kanaya/Pineapple_II/doc/hardware.md

# Pineapple II

_Edition 2.0.5 for Pineapple II version 2.0.5-Release._

Pineapple II is an artist-friendly computer that can convert analog voltage to MIDI signal.

## Overview

Pineapple II can take up to 4 analog inputs (0-5V) and converts them to MIDI signals. An edge of the analog signal (e.g. 0V to 0.1V) causes MIDI Note On signal. Continuous change of the input voltage causes MIDI Control Change, and drop to 0V causes MIDI Note Off.

Up to 4 analog sensors can be attached to Pineapple II. The sensor can be **(1) variable voltage** (0V when not active) or **(2) variable resistance** (nonconductive when not active) by activating or inactivating built-in pull-down resistors.

The sensor port (named GeekPort II) of Pineapple II has 6 pins as follows.

Table. GeekPort II Pinout

| Pin | Meaning |
|-----|---|
| G1  | GND |
| G2  | Vcc (5V) |
| G3  | Anaolg Input |
| G4  | Detector |
| G5  | I2C SDA (5V) |
| G6  | I2C SCL (5V) |

The GeekPort II uses Hirose's HR-10A connector.

If Detector is open (not connected to anything electrically), Pineapple II assumes that the sensor works in **resistance mode.** In this mode a _pull-down_ resistor attached to Analog Input is activated, and thus even if Analog Input is open, it means zero input.

If Detector is connected to GND, Pineapple II assumes that the sensor works in **voltage mode.**

Some implementation of Pineapple II has four GeekPort II _Lite_ instead of the original GeekPort II. The _Lite_ version has 4 pins as follows.

Table. GeekPort _Lite_ Pinout

| Pin | Meaning | Position |
|-----|---|---|
| g1  | Vcc (5V)  | Tip |
| g2  | Analog In | Ring 1 |
| g3  | Detector  | Ring 2 |
| g4  | GND | Sleeve |

The GeekPort II _Lite_ uses 3.5mm (1/8-inch) phone jack.

## Design

### Front Panel

Front panel of Pineapple II has 4x GeekPort II and Maintenance port.

#### GeekPort II

GeekPort II can be configured as Regular or Lite.

##### Regular (Hirose HR-10A)

| HR-10A Pin Num. | Meaning |
|---|---|
| 1 | GND |
| 2 | Power |
| 3 | Detector  |
| 4 | Analog In |
| 5 | I2C SDA |
| 6 | I2C SCL |

##### Lite (3.5mm TRRS jack)

Some imprementation of Pineapple II would come with the _Lite_ version of the ports instead of the regular ones. The _Lite_ version doesn't support I2C connection, however, it could be a reasonable option for mass production.

| Position | Meaning |
|---|---|
| Tip | Power |
| Ring 1 | Analog In |
| Ring 2 | Detector  |
| Sleeve | GND |

Note that the _Lite_ version can be TRS (tip-ring-sleave) plug if the sensor requires **voltage** mode of Pineapple II.

#### Maintenance Port (2.5mm phone jack)

The maintenance port is electronically compatible with USB 2.0.

| Position | Meaning |
|---|---|
| Tip | D- |
| Ring 1 | D+ |
| Ring 2 | GND |
| Sleeve | Vbus |

### Back Panel

#### MIDI Out+ (DIN connector)

The MIDI Out+ connector is upper compatible to the regular MIDI Out connector, and has extra TX+ and TX- pins at M6 and M8 respectively.

| MIDI Pin | Meaning |
|---|---|
| M1 | NC |
| M2 | GND |
| M3 | NC |
| M4 | Send |
| M5 | Return  |
| M6 | TX+ |
| M7 | NC |
| M8 | TX- |

Some manufacturer uses non-standard 3.5mm (1/8-inch) MIDI jacks and allows regular audio cables to connect between MIDI systems. The audio-plug version of MIDI Out connector should be looked like as follows.

| MIDI Pin (audio plug) | Meaning |
|---|---|
| Tip | Return  |
| Ring | Send |
| Sleeve | GND |

#### MIDI In+ (DIN connector)

The MIDI In+ connector is upper compatible to the regular MIDI In connector, and has extra RX+, Detect, RX- pins at m6, m7, m8 respectively. The m2 pin is connected to GND. If m7 pin is connected to m2 pin, Pineapple II switches MIDI In from m4/m5 pair to m6/m8 pair.

| MIDI Pin | Meaning |
|---|---|
| m1 | NC |
| m2 | GND |
| m3 | NC |
| m4 | Send |
| m5 | Return  |
| m6 | RX+ |
| m7 | Detect  |
| m8 | RX- |

The audio-plug version of MIDI In should be looked like as follows.

| MIDI Pin (audio plug) | Meaning |
|---|---|
| Tip | Return  |
| Ring | Send |

#### DC Jack (EIAJ Class-4 jack)

The DC jack can be either EIAJ-4 power jack or standard 5.5mm/2.1mm power jack.

| DC Jack | Meaning |
|---|---|
| PWR-Center | DC +9V  |
| PWR-Sleeve | GND |

#### Reset SW

| SW | Meaning |
|----|---|
| SW | Reset (double-push to boot-load) |

### MPU Pinout

The core of Pineapple II is an _Arduino Micro._ (Nano and Portena version are planned in future.)

| Pin Group | Pin | Arduino Micro | Connect to | Nano* | Portena* |
|---|---|---|---|---|---|
| **MIDI** | TX | D1 (TX) | M4, M5 | TX | D14 |
| | RX | D0 (RX) | m4, m5 | RX | D13 |
| | GND | GND | M2, m2 | | |
| **MIDI DX** | TX | D1 (TX) | M6, M8 | TX | D14 |
| | RX | D0 (RX) | m6, m8 | RX | D13 |
| | GND | GND | GND | | |
| **I2C** | SDA | D2 | Gx-5, RTC-5 | A4 | D11 |
| | SCL | D3 (PWM) | Gx-6, RTC-4 | A5 | D12 |
| **Analog** | ANLG1 | A0 | G1-4/g1-R1 | A0 | A0 |
| | ANLG2 | A1 | G2-4/g2-R1 | A1 | A1 |
| | ANLG3 | A2 | G3-4/g3-R1 | A2 | A2 |
| | ANLG4 | A3 | G4-4/g4-R1 | A3 | A3 |
| | PDN | A4 | --- | A6 | A4 |
| | AREF | AREF | --- | AREF  | AREF |
| | Vout | --- | Gx-1/gx-T | | |
| | GND | GND | Gx-2/gx-S | | |
| **Detector**  | DTCT1 | D6/A7 (PMW) | G1-3/g1-R2 | D6~ | D0~ |
| | DTCT2 | D9/A9 (PWM) | G2-3/g2-R2 | D9~ | D1~ |
| | DTCT3 | D10/A10 (PMW) | G3-3/g3-R2 | D10~  | D2~ |
| | DTCT4 | D12/A11 | G4-3/g4-R2 | D12~  | D3~ |
| **Indicator** | LED0 | D13 (PWM) | Green LED | D13~  | D4~ |
| | LED1 | D11 (PWM) | Red LED | D11~  | D5~ |
| **Reset** | RST | Reset | SW | | |
| **Power** | Vin | VIN | P-Center | | |
| | GND | GND | P-Sleeve | | |
| **X** | Vcc | Vcc | X1 | | |
| | D7 | D7 | X2 | D7~ | D7 |
| | SCL | D3 | X3 | SCL | D12 |
| | SDA | D2 | X4 | SDA | D11 |
| | GND | GND | X5 | | |
| **Y** | GPIO1 | D5 (PWM) | Y2 | D5~ | D6~ |
| | GPIO2 | D8/A8 | Y3 | D8~ | D8 |
| | GND | GND | Y1 | | |
| **Internal**  | THS | A5 | Thermal sensor  | A7 | A5 |
| | RLY | D4/A6 | Thermal breaker | D4~ | A6 |
| **Reserved**  | | | | D2~ | D9 |
| | | | | D3~ | D10 |

*Future releases.

### Board Connectors

#### Front Connector (MIL 26p Connector)

| Pin | Meaning | Connect to | Connect to (Lite) |
|-----|---|---|---|
| F01 | GND | G1-1 | g1-S |
| F02 | Vout | G1-2 | g1-T |
| F03 | Detector 1 | G1-3 | g1-R2 |
| F04 | Analog 1 | G1-4 | g1-R1 |
| F05 | GND | G2-1 | g2-S |
| F06 | Vout | G2-2 | g2-T |
| F07 | Detector 2 | G2-3 | g2-R2 |
| F08 | Analog 2 | G2-4 | g2-R1 |
| F09 | GND | G3-1 | g3-S |
| F10 | Vout | G3-2 | g3-T |
| F11 | Detector 3 | G3-3 | g3-R2 |
| F12 | Analog 3 | G3-4 | g3-R1 |
| F13 | GND | G4-1 | g4-S |
| F14 | Vout | G4-2 | g4-T |
| F15 | Detector 4 | G4-3 | g4-R2 |
| F16 | Analog 4 | G4-4 | g4-R1 |

#### Back Connector (MIL 20p Connector)

| Pin | Meaning | Connect to |
|-----|---|---|
| B01 | GND | PWR-Sleeve |
| B02 | DC9V | PWR-Center |
| B03 | Reset | SW1 |
| B04 | GND | SW2 |
| B05 | LED0 | NC |
| B06 | GND | m2 |
| B07 | MIDI IN Send | m4 |
| B08 | MIDI IN Return | m5 |
| B09 | MIDI RX+ | m6 |
| B10 | MIDI RX Detect | m7 |
| B11 | MIDI RX- | m8 |
| B12 | GND | M2 |
| B13 | MIDI OUT Send | M4 |
| B14 | MIDI OUT Return  | M5 |
| B15 | MIDI TX+ | M6 |
| B16 | MIDI TX- | M8 |
| B17 | MIDI OUT2 Send | (m4) |
| B18 | MIDI OUT2 Return | (m5) |
| B19 | MIDI THRU Send | (M4) |
| B20 | MIDI THRU Return | (M5) |

#### I2C/Display Connector

| Pin | Meaning |
|-----|---|
| X1  | GND |
| X2  | SDA |
| X3  | SCL |
| X4  | D7 |
| X5  | Vcc |

| Pin | Meaning |
|-----|---|
| Y1  | GND |
| Y2  | GPIO1 |
| Y3  | GPIO2 |

#### Power Connector

| Pin | Meaning |
|-----|---|
| V1  | GND |
| V2  | Vcc |

#### LED Connector

| Pin | Meaning |
|-----|---|
| L1  | GND |
| L2  | LED0 |
| L3  | LED1 |

## Experimental Feature

### Power Connector

Pineapple II has 2-pin PH connector pad at the back of the PCB.

### Qwiic-Compatible Connector

Pineapple II has SparkFun's Qwiic-compatible connector pad at the back of the PCB.

## Componetns

| Kind | Symbol | Specification | Size |
|---|---|---|---|
| Capacitor | C1 | 22u (226) | 100mil |
| | C2 | 470u (474) | 200mil |
| | C3 | 1u (105) | 200mil |
| | C4 | 100n (104) | 100mil |
| | C5 | 100n (104) | 100mil |
| | C6 | 10n (103) | 100mil |
| | C7 | 10n (103) | 100mil |
| | C8 | 10n (103) | 100mil |
| | C9 | 10n (103) | 100mil |
| | C10 | 100n (104) | 100mil |
| | C11 | 10n (103) | 2012 |
| | C12 | 10n (103) | 2012 |
| | C13 | 10n (103) | 2012 |
| Diode | D1 | 1S3 | |
| | D2 | 1S3 | |
| | D3 | 1S3 | |
| Fuse | F1 | | |
| IC | IC1 | 74LS07N | |
| | IC2 | 4066N | |
| | IC11 | 74LS153D | |
| | IC12 | LTC485 | |
| | IC13 | LTC485 | |
| Connector | J1 | JST PH 5p | |
| | J2 | JST PH 3p Vertical | |
| | J3 | JST PH 4p Vertical | |
| | J4 | JST PH 2p Vertical | |
| | J5 | JST PH 3p | |
| | J11 | JST SH 4p | |
| | J12 | JST SH 4p | |
| | J13 | JST SH 4p | |
| | J14 | JST SH 4p | |
| Jumper | JP1 | Pinheader 1x2 | |
| | JP2 | Pinheader 1x2 | |
| | JP3 | Pinheader 2x3 | |
| | JP4 | Pinheader 1x2 | |
| | JP5 | Pinheader 1x5 | |
| Relay | K1 | G5V-1 | |
| Micro Controller | MC1 | Arduino Micro | |
| Optocoupler | OK1 | TLP552 | |
| Resistor | R1 | 47k (473) | |
| | R2 | 1k (102) | |
| | R3 | 1k (102) | |
| | R4 | 120 (121) | |
| | R5 | 120 (121) | |
| | R11 | 10k (103) | 2012 |
| | R12 | 120 (121) | 2012 |
| | R13 | 120 (121) | 2012 |
| Resistor Net | RN1 | 4.7k 4-elements | |
| | RN2 | 10k 4-elements | |
| | RN3 | 220 8-elements DIL | |
| Connector ML | SV1 | 16p | |
| | SV2 | 20p | |
| Transistor | T1 | 2SC1815Y | |
| Thermal Sensor | U1 | DS18B20 | |
| V. Regulator | V1 | L7805 | |
