kanaya/Pineapple_II/hardware/logicboard/p2-001.brd

## EAGLE design hardware/logicboard/p2-001.brd (2022-10-15)

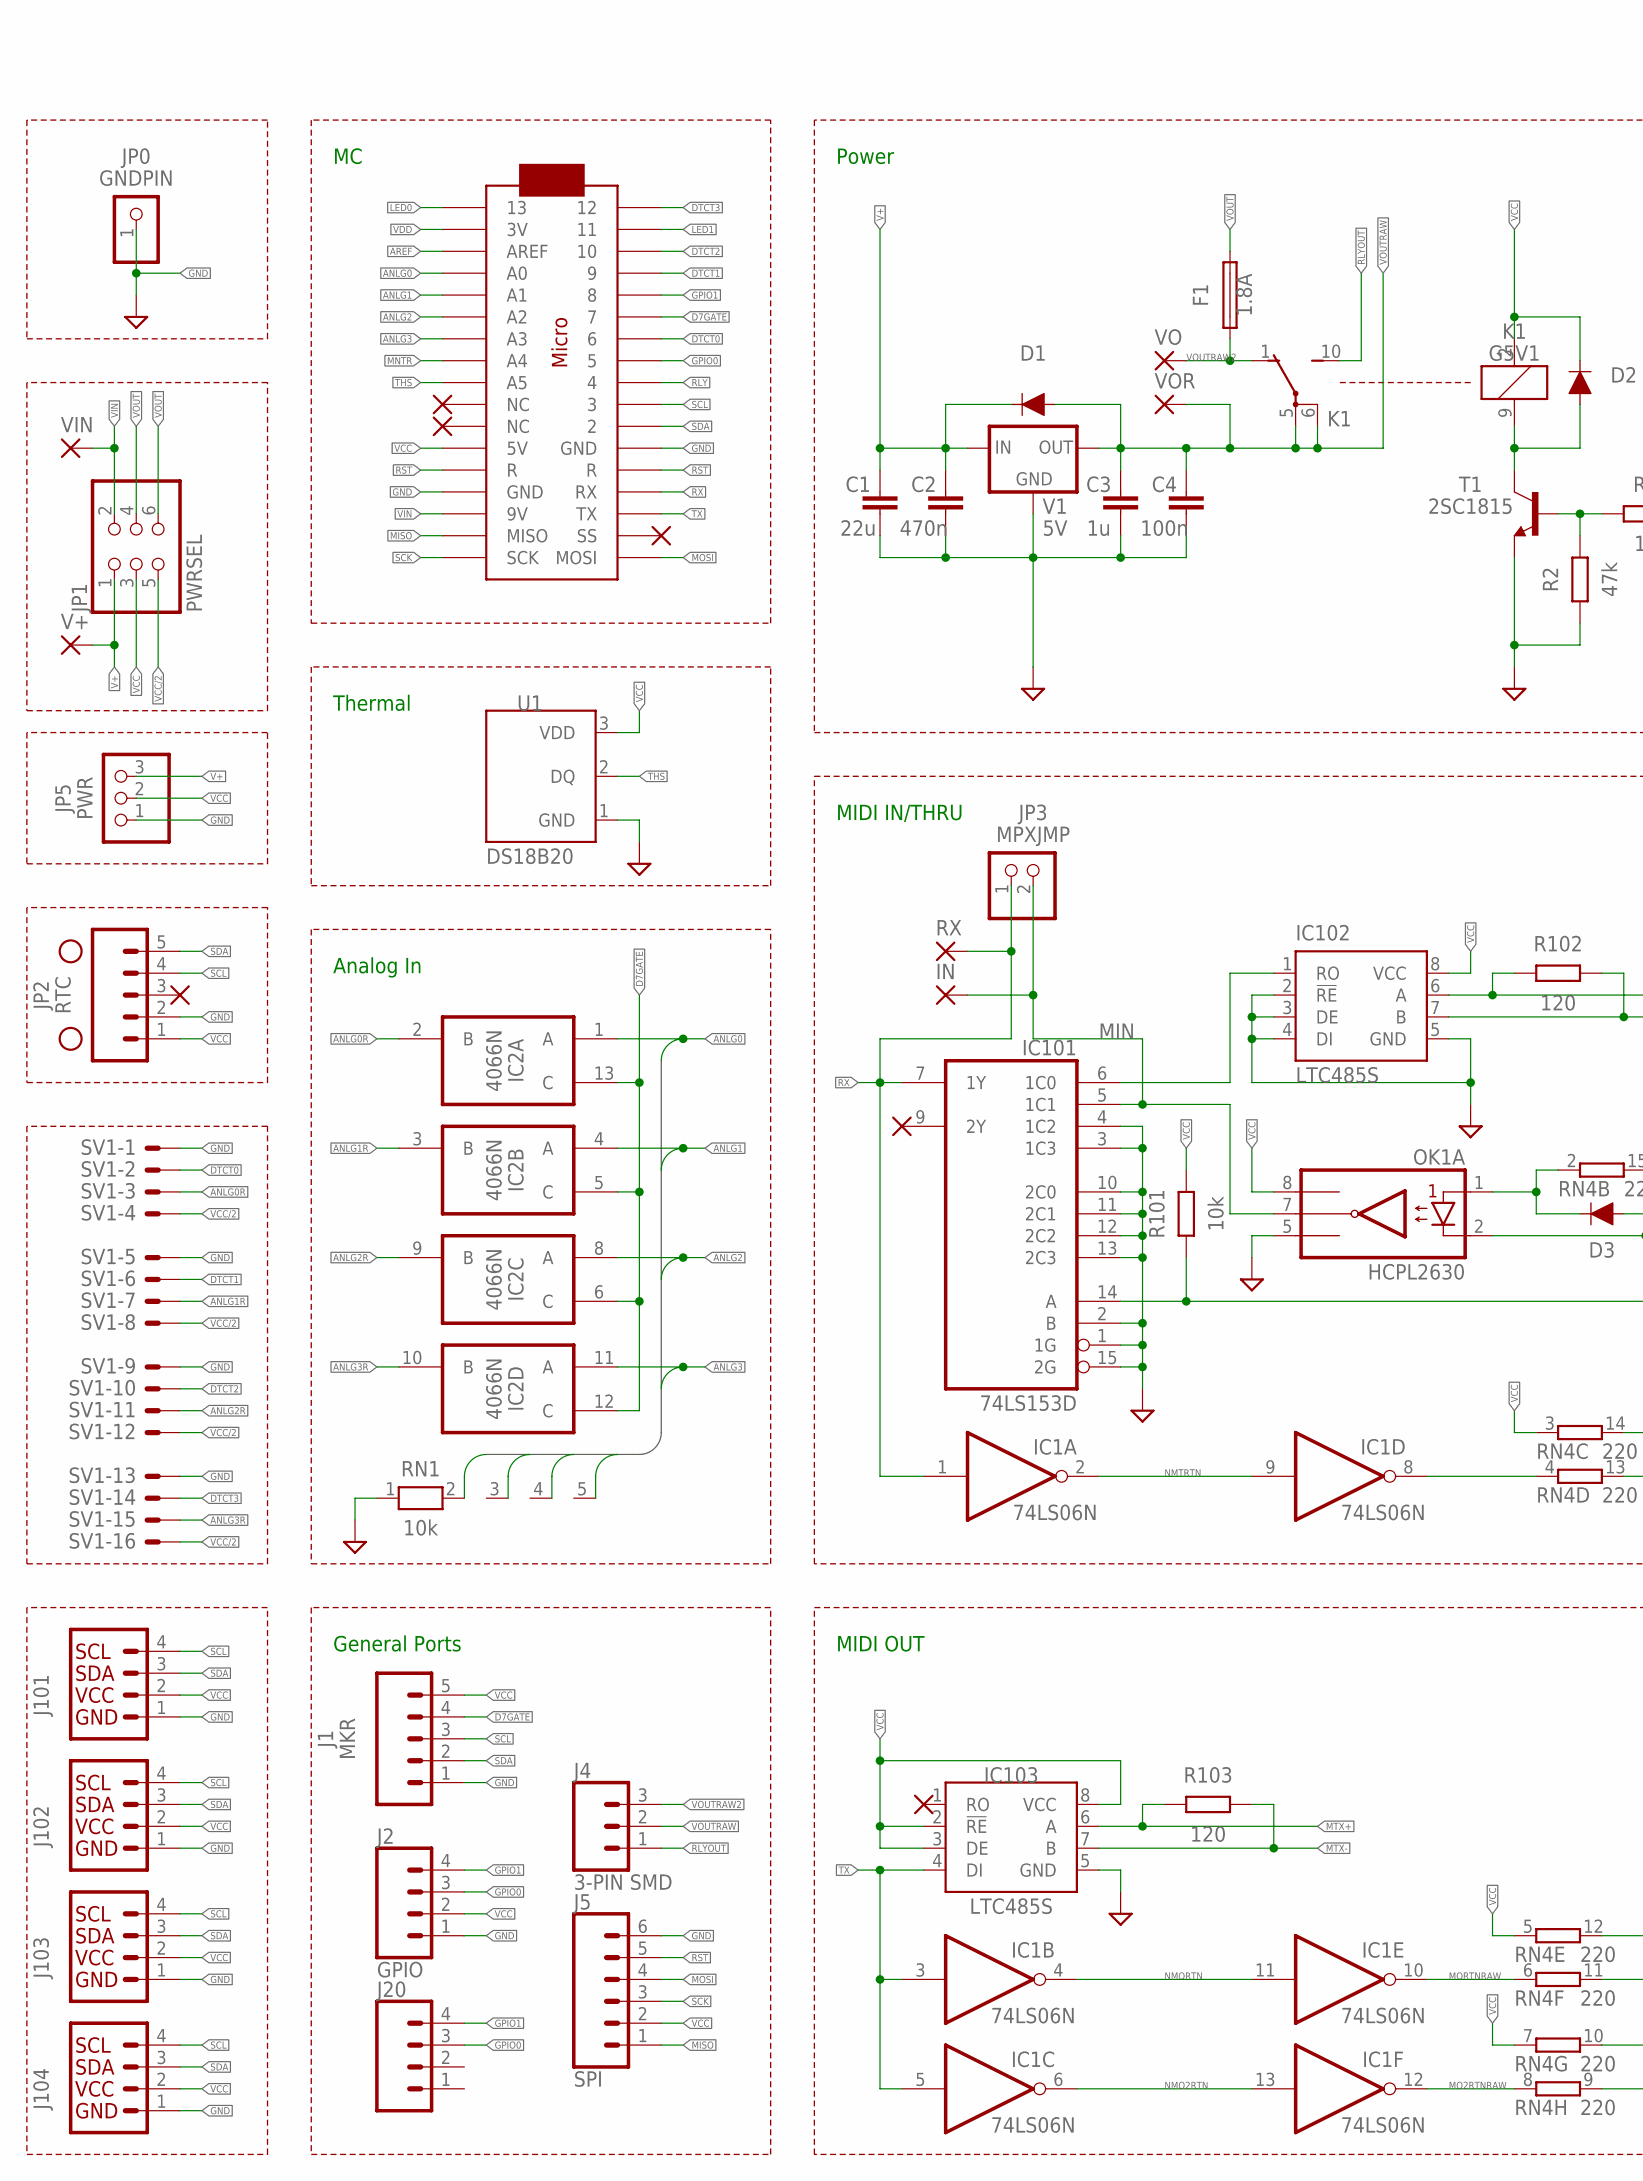
[picture p1: schematic p2-001.sch, part in row 1, column 1]

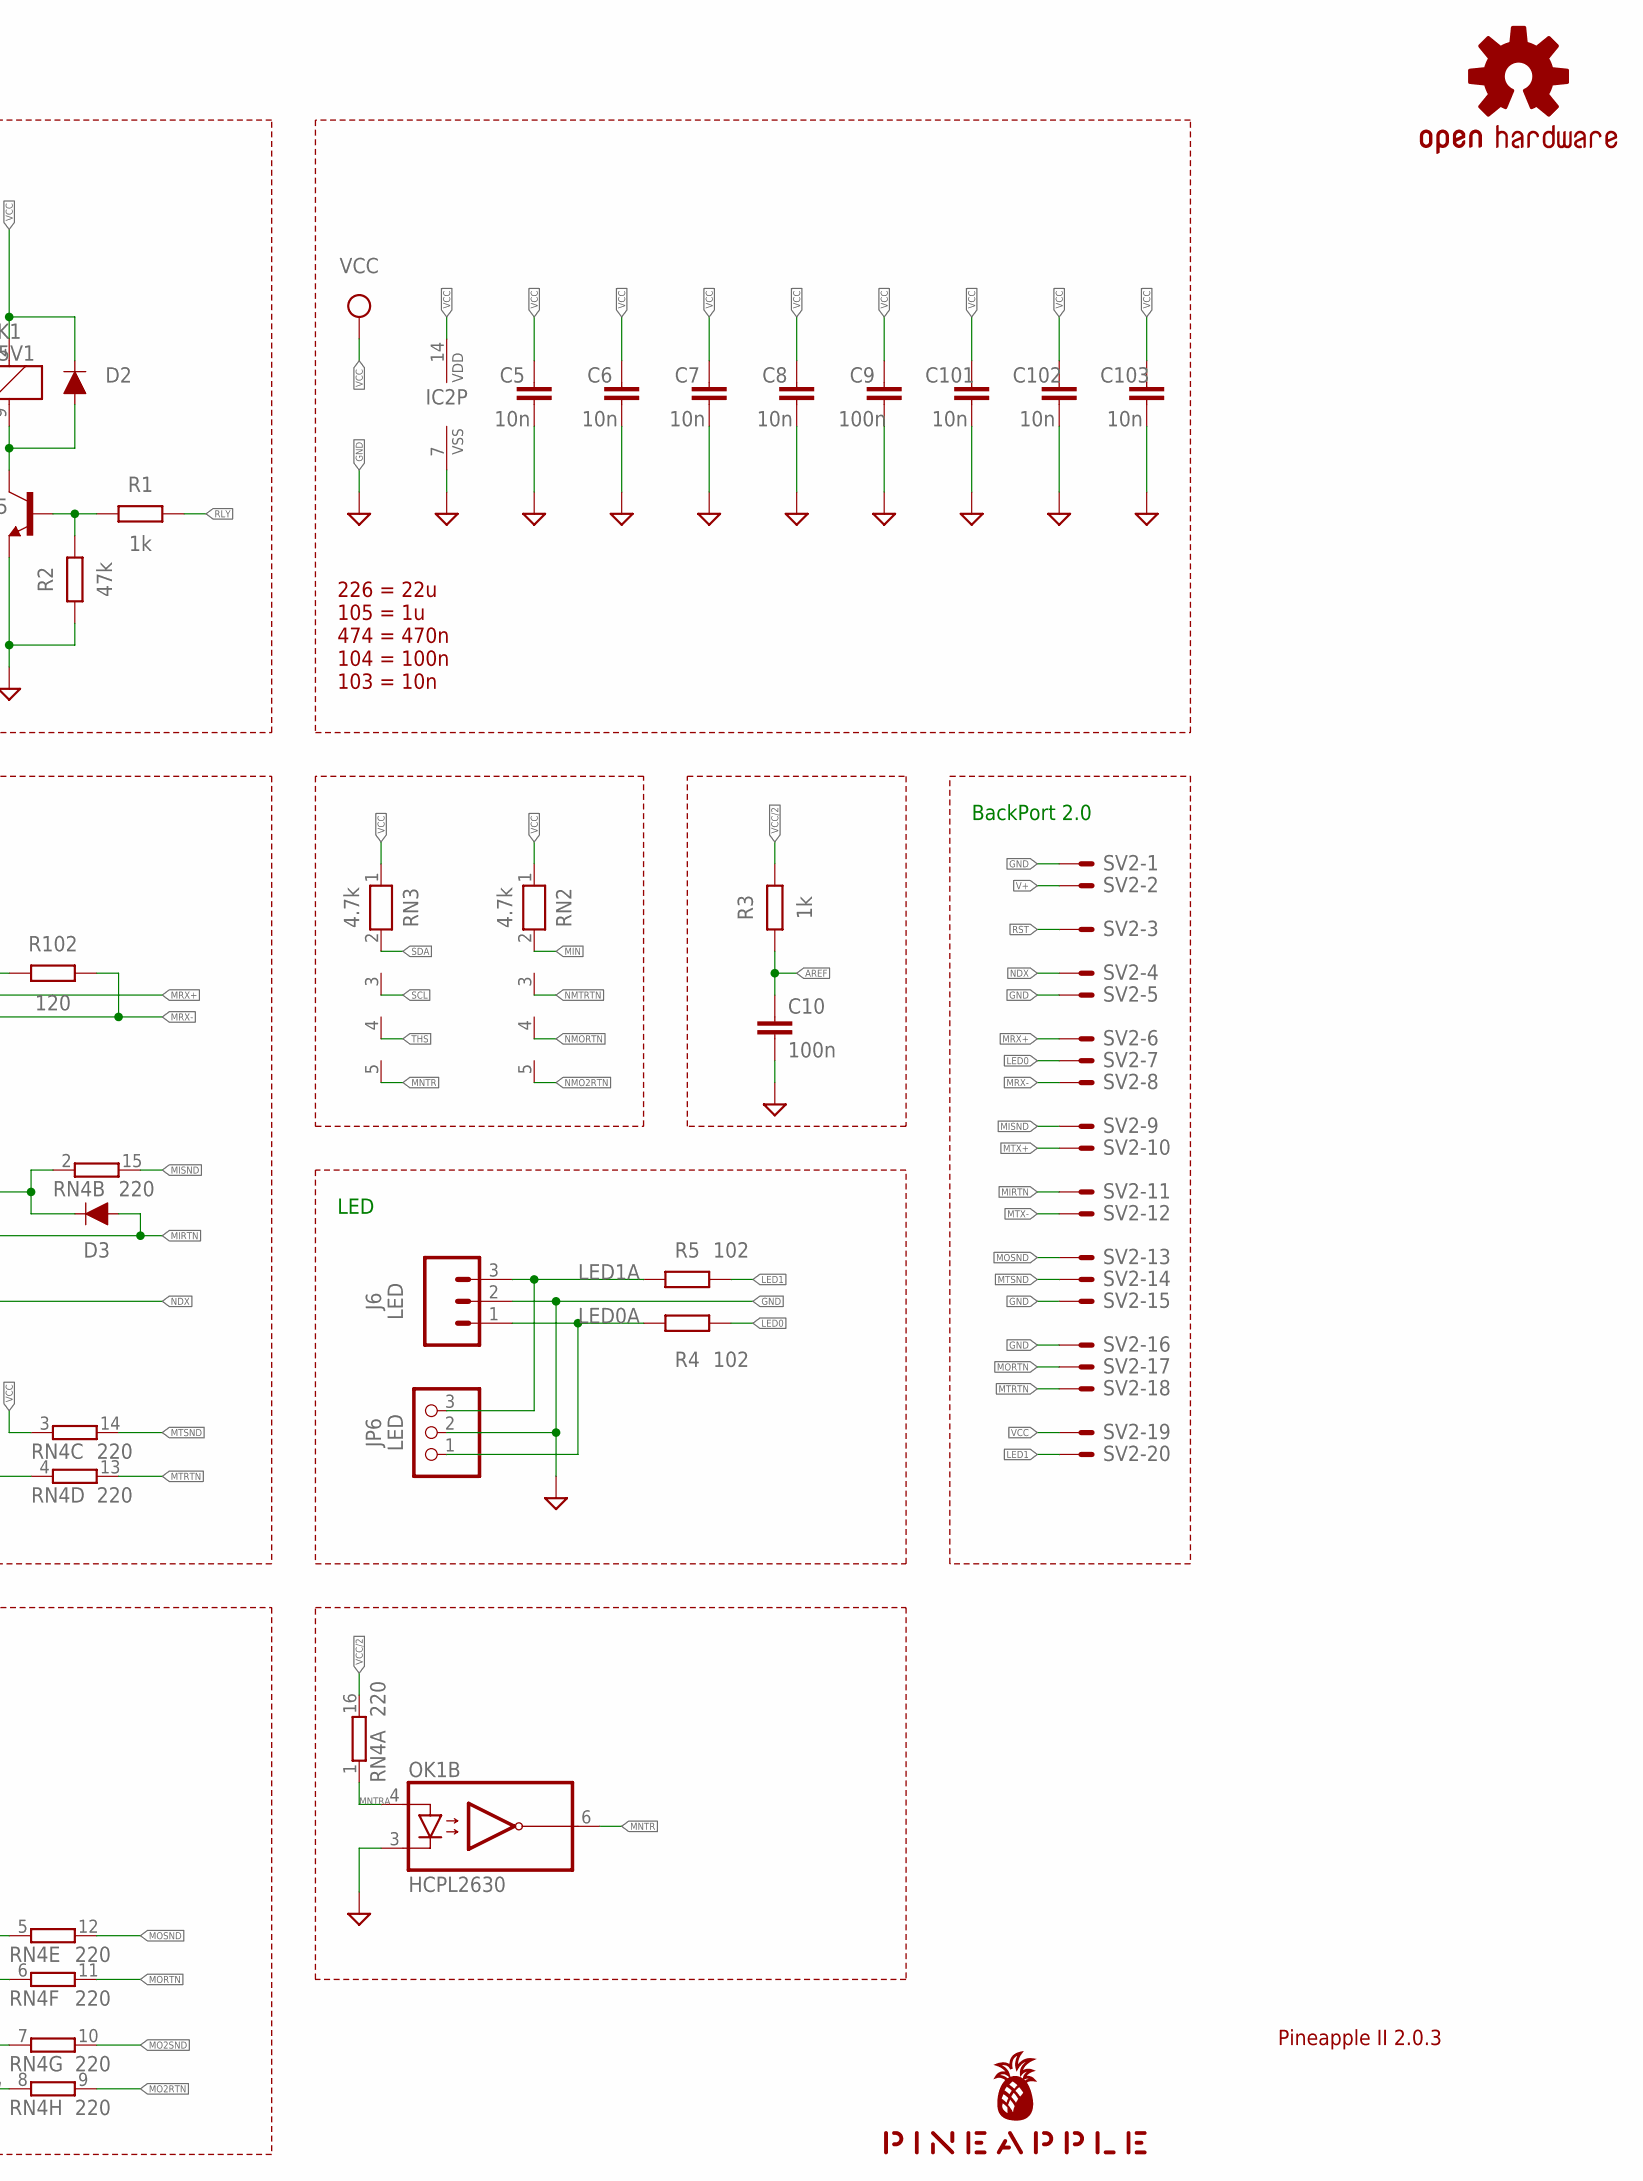
[picture p2: schematic p2-001.sch, part in row 1, column 2]

Parts:
C1: 22u; C025-050X050
C2: 470n; C050-024X044
C3: 1u; C050-024X044
C4, C9, C10: 100n; C025-024X044
C5, C6, C7, C8: 10n; C025-024X044
C101, C102, C103: 10n; C2012
D1, D2, D3: DIODE-1N4148
F1: 1.8A; TE5
H1, H2: STAND-OFF
IC1: 74LS06N; DIL14
IC2: 4066N; DIL14
IC101: 74LS153D; SO16
IC102, IC103: LTC485S; SOIC8
IN: SMD2; SMD1,27-2,54
J1: MKR; JST-5-PTH
J2: GPIO; JST-4-PTH
J4: 3-PIN SMD; JST-3-SMD
J5: SPI; 1X06_1.27MM
J6: LED; JST-3-PTH
J20: CONN_041.27MM; 1X04_1.27MM
J101, J102, J103, J104: Qwiic; 1X04_1MM_RA
JP0: GNDPIN; 1X01
JP1: PWRSEL; 2X03
JP2: RTC; 1X05
JP3: MPXJMP; 1X02
JP5: PWR; 1X03
JP6: LED; 1X03
K1: G5V1
LOGO1: OSHW-LOGOS-COPPER; OSHW-LOGO-S_COPPER
MC1: ARDUINOMICRO
OK1: HCPL2630; DIL08
R1, R3: 1k; 0204/5
R2: 47k; 0204/5
R4, R5: 102; 0204/5
R101: 10k; M2012
R102, R103: 120; M2012
RN1: 10k; RN-5
RN2, RN3: 4.7k; RN-5
RN4: 220; DIL16
RX: SMD2; SMD1,27-2,54
SV1: ML16LE; ML16L
SV2: ML20LE; ML20L
T1: 2SC1815; TO92-ECB
U1: DS18B20; TO-92-AMMO
U$1: PINEAPPLE450_SILK
V1: 5V; 78XXL
V+: SMD2; SMD1,27-2,54
VIN: SMD2; SMD1,27-2,54
VO: SMD2; SMD1,27-2,54
VOR: SMD2; SMD1,27-2,54

Connections:
ANLG0: IC2.1 (A), MC1.P$31 (A0), RN1.2
ANLG0R: IC2.2 (B), SV1.3
ANLG1: IC2.4 (A), MC1.P$30 (A1), RN1.3
ANLG1R: IC2.3 (B), SV1.7
ANLG2: IC2.8 (A), MC1.P$29 (A2), RN1.4
ANLG2R: IC2.9 (B), SV1.11
ANLG3: IC2.11 (A), MC1.P$28 (A3), RN1.5
ANLG3R: IC2.10 (B), SV1.15
AREF: C10.1, MC1.P$32 (AREF), R3.1
D7GATE: IC2.5 (C), IC2.6 (C), IC2.12 (C), IC2.13 (C), J1.4, MC1.P$6 (7)
DTCT0: MC1.P$7 (6), SV1.2
DTCT1: MC1.P$4 (9), SV1.6
DTCT2: MC1.P$3 (10), SV1.10
DTCT3: MC1.P$1 (12), SV1.14
GND: C1.2, C2.2, C3.2, C4.2, C5.2, C6.2, C7.2, C8.2, C9.2, C10.2, C101.2, C102.2, C103.2, IC1.7 (GND), IC2.7 (VSS), IC101.1 (1G), IC101.2 (B), IC101.3 (1C3), IC101.4 (1C2), IC101.8 (GND), IC101.10 (2C0), IC101.11 (2C1), IC101.12 (2C2), IC101.13 (2C3), IC101.15 (2G), IC102.2 (!RE), IC102.3 (DE), IC102.4 (DI), IC102.5 (GND), IC103.5 (GND), J1.1, J2.1, J5.6, J6.2, J101.1 (GND), J102.1 (GND), J103.1 (GND), J104.1 (GND), JP0.1, JP2.2, JP5.1, JP6.2, MC1.P$12 (GND), MC1.P$21 (GND), OK1.3 (C2), OK1.5 (GND), R2.1, RN1.1, SV1.1, SV1.5, SV1.9, SV1.13, SV2.1, SV2.5, SV2.15, SV2.16, T1.E, U1.1 (GND), V1.GND
GPIO0: J2.3, J20.3, MC1.P$8 (5)
GPIO1: J2.4, J20.4, MC1.P$5 (8)
LED0: MC1.P$34 (13), R4.2, SV2.7
LED0A: J6.1, JP6.1, R4.1
LED1: MC1.P$2 (11), R5.2, SV2.20
LED1A: J6.3, JP6.3, R5.1
MIDIINSND: D3.C, OK1.1 (A1), RN4.2 (1)
MIN: IC101.5 (1C1), IN.1, JP3.2, OK1.7 (VO1), RN2.2
MIRTN: D3.A, OK1.2 (C1), SV2.11
MISND: RN4.15 (2), SV2.9
MISO: J5.1, MC1.P$19 (MISO)
MNTR: MC1.P$27 (A4), OK1.6 (VO2), RN3.5
MNTRA: OK1.4 (A2), RN4.1
MO2RTN: RN4.9 (2)
MO2RTNRAW: IC1.12 (O), RN4.8 (1)
MO2SND: RN4.10 (2)
MORTN: RN4.11 (2), SV2.17
MORTNRAW: IC1.10 (O), RN4.6 (1)
MOSI: J5.4, MC1.P$17 (MOSI)
MOSND: RN4.12 (2), SV2.13
MRX: IC101.6 (1C0), IC102.1 (RO)
MRX+: IC102.6 (A), R102.1, SV2.6
MRX-: IC102.7 (B), R102.2, SV2.8
MTRTN: RN4.13 (2), SV2.18
MTRTNRAW: IC1.8 (O), RN4.4 (1)
MTSND: RN4.14 (2), SV2.14
MTX+: IC103.6 (A), R103.1, SV2.10
MTX-: IC103.7 (B), R103.2, SV2.12
NDX: IC101.14 (A), R101.1, SV2.4
NMO2RTN: IC1.6 (O), IC1.13 (I), RN2.5
NMORTN: IC1.4 (O), IC1.11 (I), RN2.4
NMTRTN: IC1.2 (O), IC1.9 (I), RN2.3
RLY: MC1.P$9 (4), R1.2
RLYDRV: R1.1, R2.2, T1.B
RLYSNK: D2.A, K1.9 (2), T1.C
RST: J5.5, MC1.P$13 (R), MC1.P$22 (R), SV2.3
RX: IC1.1 (I), IC101.7 (1Y), JP3.1, MC1.P$14 (RX), RX.1
SCK: J5.3, MC1.P$18 (SCK)
SCL: J1.3, J101.4 (SCL), J102.4 (SCL), J103.4 (SCL), J104.4 (SCL), JP2.4, MC1.P$10 (3), RN3.3
SDA: J1.2, J101.3 (SDA), J102.3 (SDA), J103.3 (SDA), J104.3 (SDA), JP2.5, MC1.P$11 (2), RN3.2
THS: MC1.P$26 (A5), RN3.4, U1.2 (DQ)
TX: IC1.3 (I), IC1.5 (I), IC103.4 (DI), MC1.P$15 (TX)
V+: C1.1, C2.1, D1.C, JP1.1, JP5.3, SV2.2, V1.IN, V+.1
VCC: C5.1, C6.1, C7.1, C8.1, C9.1, C101.1, C102.1, C103.1, D2.C, IC1.14 (VCC), IC2.14 (VDD), IC101.16 (VCC), IC102.8 (VCC), IC103.2 (!RE), IC103.3 (DE), IC103.8 (VCC), J1.5, J2.2, J5.2, J101.2 (VCC), J102.2 (VCC), J103.2 (VCC), J104.2 (VCC), JP1.3, JP2.1, JP5.2, K1.2 (1), MC1.P$23 (5V), OK1.8 (VCC), R101.2, RN2.1, RN3.1, RN4.3 (1), RN4.5 (1), RN4.7 (1), SV2.19, U1.3 (VDD)
VCC/2: JP1.5, R3.2, RN4.16 (2), SV1.4, SV1.8, SV1.12, SV1.16
VDD: MC1.P$33 (3V)
VIN: JP1.2, MC1.P$20 (9V), VIN.1
VOUT: F1.2, JP1.4, JP1.6
VOUTRAW: C3.1, C4.1, D1.A, J4.2, K1.5, K1.6, V1.OUT, VOR.1

Notes on the sheet:
Pineapple II 2.0.3
226 = 22u 105 = 1u 474 = 470n 104 = 100n 103 = 10n
MIDI IN/THRU
MIDI OUT
Power
General Ports
Analog In
Thermal
LED
BackPort 2.0

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
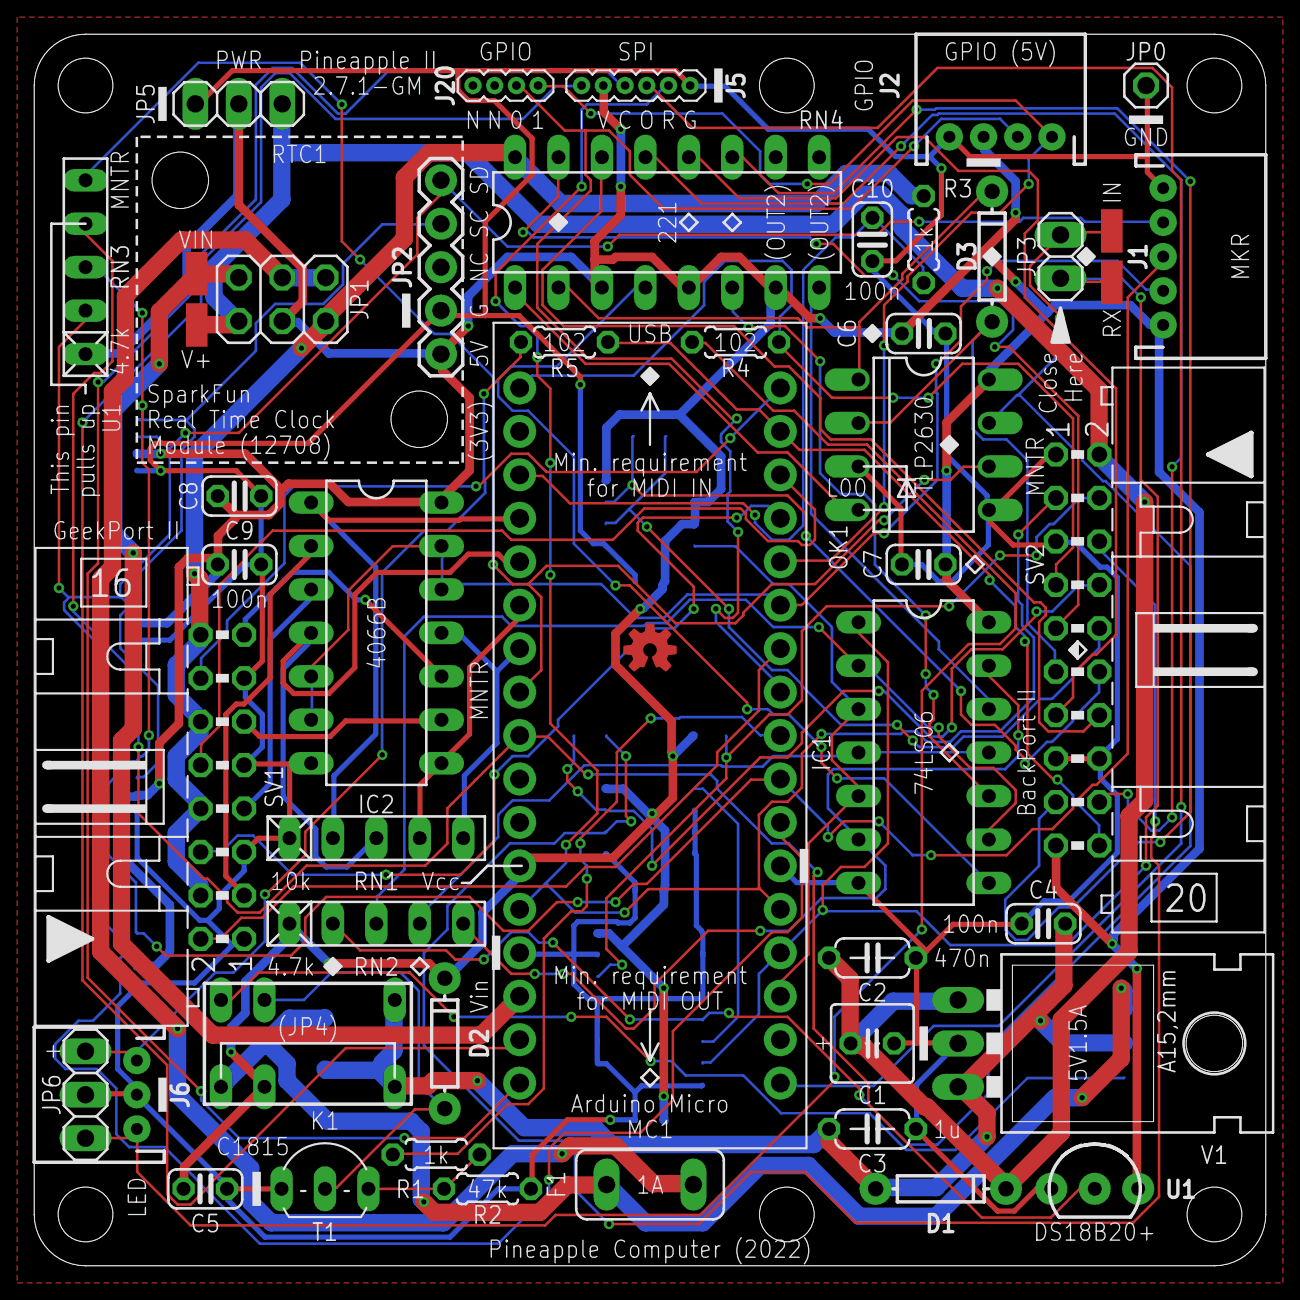
[picture p3: board p2-001.brd from above]

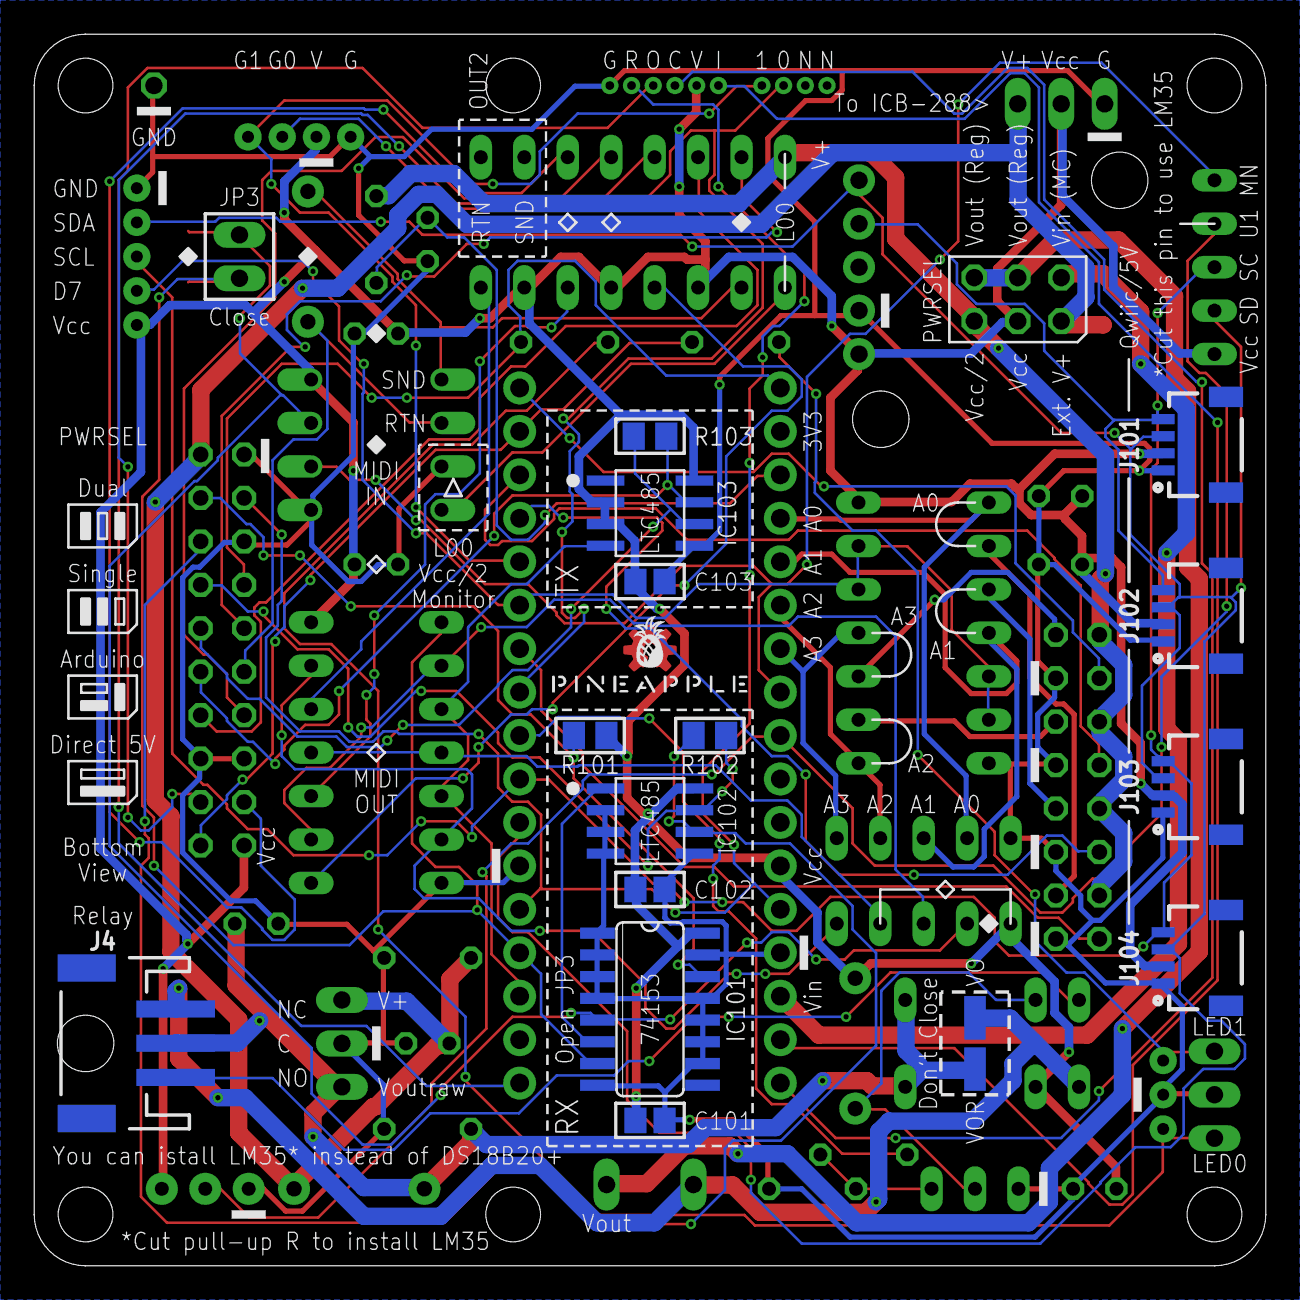
[picture p4: board p2-001.brd from below]

Board: 2 copper layers, 72.0 x 72.0 mm, 68 parts (17 on the bottom side), 63 nets.
