kanaya/Pineapple_II/(commit log)

2020-01-31 Copied 2.0.0-X1 from the old repo.
    [p2-001.brd, p2-001.sch]
2020-01-31 New design for 2.0.1.
    [p2-001.brd, p2-001.sch]
2020-02-01 Fixed power supply.
    [p2-001.brd, p2-001.sch]
2020-02-08 Fixed position of large capacitors.
    [p2-001.brd, p2-001.sch]
2020-02-09 Unified all buses.
    [p2-001.brd, p2-001.sch]
2020-02-09 Now front LED is bi-color.
    [p2-001.brd, p2-001.sch]
2020-02-09 PH connector.
    [p2-001.brd, p2-001.sch]
2020-02-09 Now pin 3 of MIDI In+ is connected to PUP pin.
    [p2-001.brd, p2-001.sch]
2020-02-10 MIDI In detector.
    [p2-001.brd, p2-001.sch]
2020-02-10 Added MIDI receiver unit.
    [p0-001.brd, p0-001.sch]
2020-02-11 Moved peripheral dir to the top.
    [p0-001.brd, p0-001.sch]
2020-02-12 Now U1 can be ether 1-Wire or Analog thermal sensor.
    [p2-001.brd, p2-001.sch]
2020-02-12 Pin 25 of Front Connector is now connected to LED0.
    [p2-001.brd, p2-001.sch]
2020-02-12 Now the sensors are connected to pull-down resistors.
    [p2-001.brd, p2-001.sch]
2020-02-12 Silk and document.
    [p2-001.brd, p2-001.sch]
2020-02-13 Qwiic (3.3V I2C) connector and signal level converter at the back surface.
    [p2-001.brd, p2-001.sch]
2020-02-13 DC-In connector.
    [p2-001.brd, p2-001.sch]
2020-02-14 Fine tune of silk.
    [p2-001.brd]
2020-02-14 Set vRestrict zones.
    [p2-001.brd]
2020-02-14 Changed vRestricted zones.
    [p2-001.brd]
2020-02-14 Minor change of silk and vRestrict zones.
    [p2-001.brd]
2020-02-14 Qwiic 5V.
    [p2-001.brd, p2-001.sch]
2020-02-18 Pull up of RX.
    [p2-001.brd, p2-001.sch]
2020-02-18 Pinhead for Relay.
    [p2-001.brd, p2-001.sch]
2020-02-29 Clean up of document, schematic, and board design.
    [p0-001.brd, p0-001.sch, p2-001.brd, p2-001.sch]
2020-02-29 Name of signal.
    [p2-001.brd, p2-001.sch]
2020-03-01 GND net.
    [p2-001.brd]
2020-03-23 Now MIDI In+ has Aux pin.
    [p2-001.brd, p2-001.sch]
2020-03-24 Pull-down resistor from 100 to 10k.
    [p2-001.brd, p2-001.sch]
2020-03-24 Changed pinout of Display port.
    [p2-001.brd, p2-001.sch]
2020-03-25 Document update.
    [p2-001.brd, p2-001.sch]
2020-04-18 F25 is now connected to AREF.
    [p2-001.brd, p2-001.sch]
2020-04-28 Now front port is Pineapple IIc compatible.
    [p2-001.brd, p2-001.sch]
2020-05-06 Renumbered number of jumpers.
    [p2-001.brd, p2-001.sch]
2020-05-06 Now Vcc is directly connected to the regulator.
    [p2-001.brd, p2-001.sch]
2020-05-07 Changed resistance attached to LED.
    [p2-001.brd, p2-001.sch]
2020-05-07 Changed position of capacitors.
    [p2-001.brd, p2-001.sch]
2020-05-11 Placed RTC board.
    [p2-001.brd, p2-001.sch]
2020-05-11 To be renumbered.
    [p2-001.brd, p2-001.sch]
2020-05-12 Fixed part numbers and silks.
    [p2-001.brd, p2-001.sch]
2020-05-12 Fixed silk.
    [p2-001.brd]
2020-05-12 Fixed pattern of RTC.
    [p2-001.brd, p2-001.sch]
2020-05-13 Removed RLY con. Removed +9V con. Added I2C and Vdd con.
    [p2-001.brd, p2-001.sch]
2020-05-13 Changed connectors of longrange receiver.
    [p0-001.brd, p0-001.sch]
2020-05-16 Looks good.
    [p2-001.brd, p2-001.sch]
2020-05-17 First try.
    [p2-001.brd, p2-001.sch]
2020-05-17 Fixed some error.
    [p2-001.brd, p2-001.sch]
2020-05-19 New display connector.
    [p2-001.brd, p2-001.sch]
2020-05-19 Removed bus.
    [p2-001.brd, p2-001.sch]
2020-05-19 A little bit better.
    [p2-001.brd, p2-001.sch]
2020-05-20 Rough design. Looks okay.
    [p2-001.brd, p2-001.sch]
2020-06-02 Changed power supply.
    [p2-001.brd, p2-001.sch]
2020-06-03 Added power selector.
    [p2-001.brd, p2-001.sch]
2020-06-04 Added relay-out connector (again).
    [p2-001.brd, p2-001.sch]
2020-06-28 Rounded corners.
    [p2-001.brd]
2020-07-06 Added Vin mark on the board.
    [p2-001.brd]
2020-07-08 Added Power-Grid.
    [p2-001.brd, p2-001.sch]
2020-07-09 Power Grid 2.
    [p2-001.brd, p2-001.sch]
2020-07-09 Swapped Vcc and Vcc/2.
    [p2-001.brd, p2-001.sch]
2020-07-11 Fixed some errors.
    [p2-001.brd, p2-001.sch]
2020-07-11 Changed Relay port and Alt. Power port.
    [p2-001.brd, p2-001.sch]
2020-07-15 List of components.
    [p2-001.brd, p2-001.sch]
2020-09-03 Added pads to connect MIDI IN and RX.
    [p2-001.brd, p2-001.sch]
2020-09-03 Renumbered connectors. Fixed error of silk pattern.
    [p2-001.brd, p2-001.sch]
2020-09-03 Fixed LED numbers.
    [p2-001.brd, p2-001.sch]
2020-09-03 Simulation of Arduino Nano and Portena.
2020-09-03 Clean up of schematic.
    [p2-001.brd, p2-001.sch]
2020-09-04 Moved resistor net up.
    [p2-001.brd, p2-001.sch]
2020-09-18 Added LED pins. Changed pin number of LED connectors.
    [p2-001.brd, p2-001.sch]
2020-09-24 Now B5 is connected to LED0 signal.
    [p2-001.brd, p2-001.sch]
2020-09-24 B05 is connected to LED0A (not LED0).
    [p2-001.brd, p2-001.sch]
2020-09-25 Analog input pins are now directly connected to pull-down resistor. Sensor pins are connected to analog input pins through analog switches. AREF is now connected to Vcc/2.
    [p2-001.brd, p2-001.sch]
2020-09-25 Fixed AREF. Changed PWR connector. Etc.
    [p2-001.brd, p2-001.sch]
2021-02-18 Added SPI connector.
    [p2-001.brd, p2-001.sch]
2021-02-19 Changed power pin from GND-Vcc to Vcc-GND-V+.
    [p2-001.brd, p2-001.sch]
2021-02-19 Silk. (Tentative)
    [p2-001.brd]
2021-02-22 Changed front-bus and SPI bus.
    [p2-001.brd, p2-001.sch]
2021-02-24 Created P20 (port replicator) schematic and artwork.
    [p20-001.brd, p20-001.sch]
2021-02-24 Cleared unnecessary parts.
    [p20-001.brd, p20-001.sch]
2021-02-24 Parts only. No connection.
    [p20-001.brd, p20-001.sch]
2021-02-24 The first artwork for MIDI Port Replicator.
    [p20-001.brd, p20-001.sch]
2021-02-24 Re-arrange of net resistors.
    [p2-001.brd, p2-001.sch]
2021-02-24 Silk of board.
    [p2-001.brd]
2021-02-24 Remake of port rep.
    [p20-001.brd, p20-001.sch]
2021-02-24 Fix of _main_ logic board.
    [p2-001.brd, p2-001.sch]
2021-02-24 Trying to implement a port replicator.
    [p20-001.brd, p20-001.sch]
2021-02-24 Initial layout.
    [p20-001.brd, p20-001.sch]
2021-02-27 Design of the port replicator.
    [p20-001.brd, p20-001.sch]
2021-03-01 Silk mark for MIDI-IN.
    [p2-001.brd]
2021-03-01 Silk mark for MIDI OUT.
    [p2-001.brd]
2021-03-01 Approved warnings and added silk pattern for Vdd.
    [p2-001.brd, p2-001.sch]
2021-03-01 Port replicator.
    [p20-001.brd, p20-001.sch]
2021-03-05 Changed revision name to 2.1.0-RELEASE.
    [p2-001.brd]
2021-03-08 Version of MIDI-IN, MIDI-THRU, and SPI only.
    [p2-002.brd, p2-002.sch]
2021-03-09 First working version of MIDI IN, MIDI THRU, SPI edition.
    [p2-002.brd, p2-002.sch]
2021-03-09 Set restricted zones to left and right edges.
    [p2-001.brd]
2021-03-09 Arrangement of some parts (P20).
    [p2-002.brd]
2021-03-10 DIP SW.
    [p2-002.brd, p2-002.sch]
2021-03-10 Removed PWR pins.
    [p2-002.brd, p2-002.sch]
2021-03-10 Clean up.
    [p2-001.sch]
2021-03-13 JP5 is now compatible with Euroblock.
    [p2-001.brd, p2-001.sch]
2021-03-13 The port replicator now has euroblock terminal.
    [p20-001.brd, p20-001.sch]
2021-03-13 Renewal of Port Replicator.
    [p20-001.brd, p20-001.sch]
2021-03-16 Moved relay port.
    [p2-001.brd, p2-001.sch]
2021-03-18 Stepper Driver v0.0.2-X.
    [p2-002.brd, p2-002.sch]
2021-03-19 Second try.
    [p2-001.brd, p2-001.sch]
2021-03-20 TLP552 -> TLP2630.
    [p2-001.brd, p2-001.sch]
2021-03-21 Pads to close V+ and Vin.
    [p2-001.brd, p2-001.sch]
2021-03-26 Updated backside port to 2.0.
    [p2-001.brd, p2-001.sch, p20-001.brd, p20-001.sch]
2021-03-27 Copied P2-001 to P2-003.
    [p2-003.brd, p2-003.sch]
2021-03-28 Very rough but should be okay.
    [p2-003.brd, p2-003.sch]
2021-03-28 Hotfix of the original P2.
    [p2-001.brd, p2-001.sch]
2021-03-29 Hotfix of relay connector (P2).
    [p2-001.brd]
2021-03-29 First try. Should work. Need to renumber and rename parts.
    [p2-003.brd, p2-003.sch]
2021-03-29 Renumbered some connectors.
    [p2-001.brd, p2-001.sch, p2-003.brd, p2-003.sch]
2021-03-29 Moved Pineapple IIb to an independent repo.
    [p2-003.brd, p2-003.sch]
2021-03-30 Flipped V+-Vin pads.
    [p2-001.brd]
2021-03-30 Removed SE/Lucent-P1.
    [p2-002.brd, p2-002.sch]
2021-04-02 Swapped MIDI RX+ and MIDI RX DETECT.
    [p2-001.brd, p2-001.sch]
2021-04-02 Renumbered parts of Port Replicator.
    [p20-001.brd, p20-001.sch]
2021-04-06 Fixed unconnected bus.
    [p2-001.brd, p2-001.sch]
2021-04-10 Redesign of port rep.
    [p20-001.brd, p20-001.sch]
2021-04-10 Renumbered parts of Pineapple II.
    [p2-001.brd, p2-001.sch]
2021-04-10 Renumbered parts of Pineapple II and port rep.
    [p2-001.brd, p2-001.sch, p20-001.brd, p20-001.sch]
2021-04-10 Renumbered Qwiic connectors.
    [p2-001.brd, p2-001.sch]
2021-04-10 LED -> L.
    [p20-001.brd, p20-001.sch]
2021-05-03 Fixed DTCT circuits.
    [p20-001.brd, p20-001.sch]
2021-10-31 Now power has 12mil width and superpower has 24mil width.
    [p2-001.brd, p2-001.sch]
2021-10-31 Power has 20mil width and superpower has 40mil width.
    [p2-001.brd]
2021-10-31 Updated backport pintouts of port rep.
    [p20-001.brd, p20-001.sch]
2021-10-31 Fixed netclasses.
    [p2-001.brd, p2-001.sch]
2021-10-31 Added LED00 for indicating VCC/2.
    [p2-001.brd, p2-001.sch]
2021-11-07 LED0->LED1, LED1->LED2.
    [p2-001.brd, p2-001.sch]
2021-11-07 LED0->LED1, LED1->LED2, LED4->LED0.
    [p20-001.brd, p20-001.sch]
2021-11-08 Added Vcc/2 Monitor.
    [p2-001.brd, p2-001.sch]
2021-11-08 Now Pin A4 is MNTR and connected to Vcc/2 via Optocoupler.
    [p2-001.brd, p2-001.sch]
2021-11-09 Swapped names of RN1 and RN2.
    [p2-001.brd, p2-001.sch]
2021-11-10 Added silk pattern for LED00.
    [p2-001.brd]
2021-11-10 Radius of restrict zone is now 2.25, not 2.23...
    [p2-001.brd]
2021-11-12 Check up and silk.
    [p2-001.brd]
2021-11-12 Fixed silk of backside.
    [p2-001.brd]
2021-11-21 Removed port replicator.
    [p20-001.brd, p20-001.sch]
2021-11-24 Renumbered signals and silk patterns.
    [p2-001.brd, p2-001.sch]
2021-11-29 Removed JP4.
    [p2-001.brd, p2-001.sch]
2021-11-29 Added silk of JP4.
    [p2-001.brd]
2021-11-29 Re-arranged GeekPort 2.0.
    [p2-001.brd, p2-001.sch]
2021-11-30 Redesigned BackPort.
    [p2-001.brd, p2-001.sch]
2021-11-30 BackPort II.
    [p2-001.brd, p2-001.sch]
2021-12-01 GND pattern.
    [p2-001.brd]
2021-12-13 Changed signal name from RXDTCT to NDX.
    [p2-001.brd, p2-001.sch]
2021-12-17 Fixed backside silk.
    [p2-001.brd]
2022-01-29 Modified backside silk for better readability.
    [p2-001.brd]
2022-01-29 Revision number.
    [p2-001.brd]
2022-02-02 Added restricted zone.
    [p2-001.brd]
2022-02-11 Changed resistance of R4 and R5 for LEDs.
    [p2-001.brd, p2-001.sch]
2022-08-02 Now J4 is 3-pin connector.
    [p2-001.brd, p2-001.sch]
2022-08-02 Moved J4.
    [p2-001.brd]
2022-08-02 Autoroute and GND.
    [p2-001.brd]
2022-08-16 6p SPI bus, 4p GPIO bus.
    [p2-001.brd, p2-001.sch]
2022-08-16 Fixed GPIO connection.
    [p2-001.brd, p2-001.sch]
2022-08-29 Arrange of J5 and JP5.
    [p2-001.brd]
2022-08-29 Arrangement of J5 and JP5.
    [p2-001.brd]
2022-09-13 Another GPIO port.
    [p2-001.brd, p2-001.sch]
2022-09-14 Position of PWR pins.
    [p2-001.brd]
2022-09-16 Positions of PWR and PWRSEL.
    [p2-001.brd]
2022-10-15 Changed positions of lower components.
    [p2-001.brd]
2022-10-15 Now the design passes DRC.
    [p2-001.brd]
2022-10-15 Moved Fuse by 0.25mm.
    [p2-001.brd]
2022-10-15 Moved backside components slightly.
    [p2-001.brd]
